NebraLtd/FlashStick/README.md

# FlashStick
Open source USB Adapters for popular compute modules
