NebraLtd/FlashStick/Raspberry Pi Compute Module 3/README.md

# Raspberry Pi Compute Module 1/3/3+ FlashStick

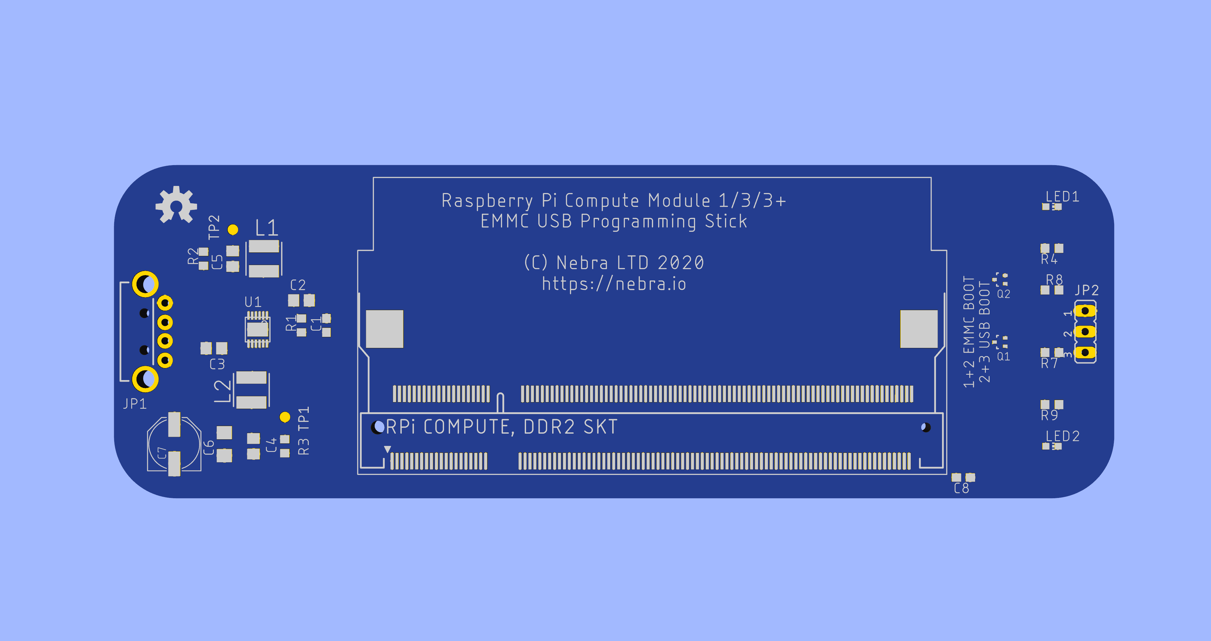
[picture p4: Raspberry Pi Compute Module 3/render-1.png]
Compute Module 1/3/3+ FlashStick


This FlashStick is designed for programming the Raspberry Pi Compute Module versions 1, 3 and 3+.

# How To Use

Operation should be as simple as:

1. Insert Compute Module 1, 3 or 3+ into FlashStick.
2. Ensure Jumper is in position 2+3.
3. Plug into Computer.
4. Load USB Boot Software (Or use Balena Etcher) to boot the CM into Programming Mode.
5. Flash image like normal.
6. Unplug stick from computer.
7. Remove compute Module.

*Care should be taken when handling the module and CM, handle from edge to reduce risk of ESD*

# PCB Specification

* **Thickness**: 1.6mm
* **Size**: 41x122mm
* **Colour**: Whatever you like, we went for blue!
* **Surface Finish**: You'll likely find assembly easier with ENIG due to the Power ICs package.
* **Stencil**: Recommended, top only. No Frame Needed.

This PCB can be quickly ordered directly from PCB companies using the following links:
* JLCPCB - CN Based - ~ $30 -
* PCBWay - CN Based - ~ $60 -
* OSHPark - US Based - ~ $70 -
* Aisler - EU Based - ~ $55 -

Or upload the Gerbers / BRD to your choice of Fab!

# Components

The BOM for shopping is in this folder.

Alternatively it's also available at [Octopart](https://octopart.com/bom-tool/03ZTTnCO) or on [Digi-key](https://www.digikey.com/short/zvwpn0)

# Assembly

We'll produce a little guide showing how we assemble them, and recommended pick and place order when doing it manually.

It's highly recommended for a Stencil to be used.

# Open Source Hardware Certification

This project is released under the [license shown here](https://github.com/NebraLtd/FlashStick/blob/main/LICENSE.md) and is also certified as [open source hardware](https://certification.oshwa.org/uk000023.html) by the [Open Source Hardware Association](https://www.oshwa.org/):

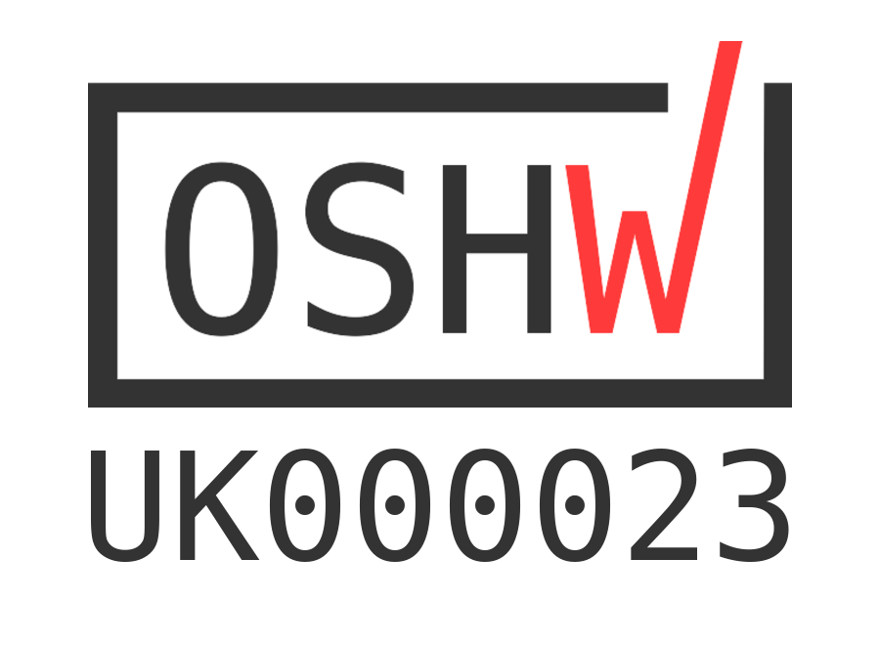
[picture p5: Raspberry Pi Compute Module 3/OSHW_mark_UK000023.png]
