NebraLtd/FlashStick/Raspberry Pi Compute Module 3/proto-1.jpg

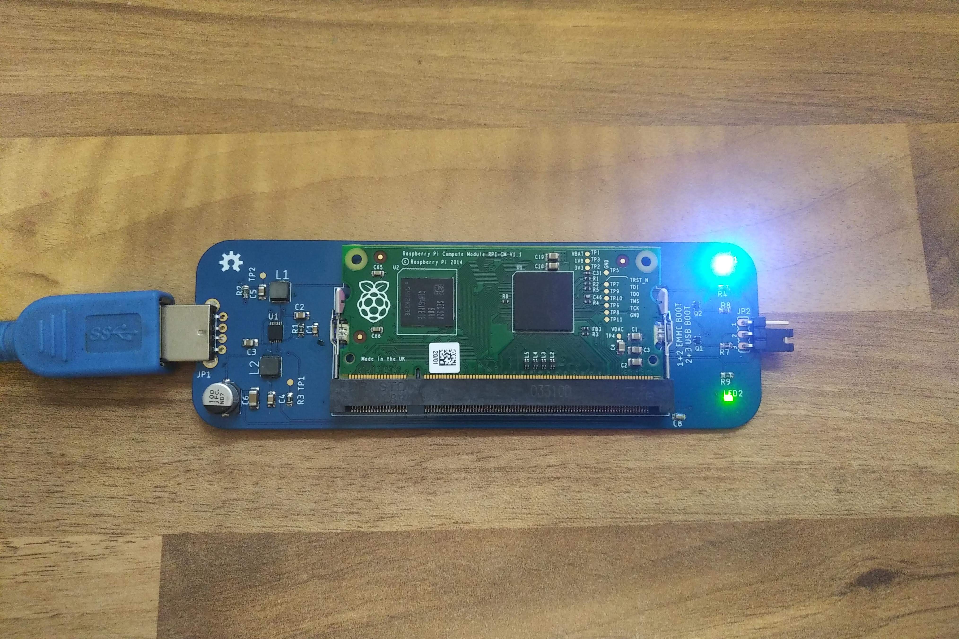
Raspberry Pi Compute Module 3/proto-1.jpg
