NebraLtd/FlashStick/Raspberry Pi Compute Module 3/proto-2.jpg

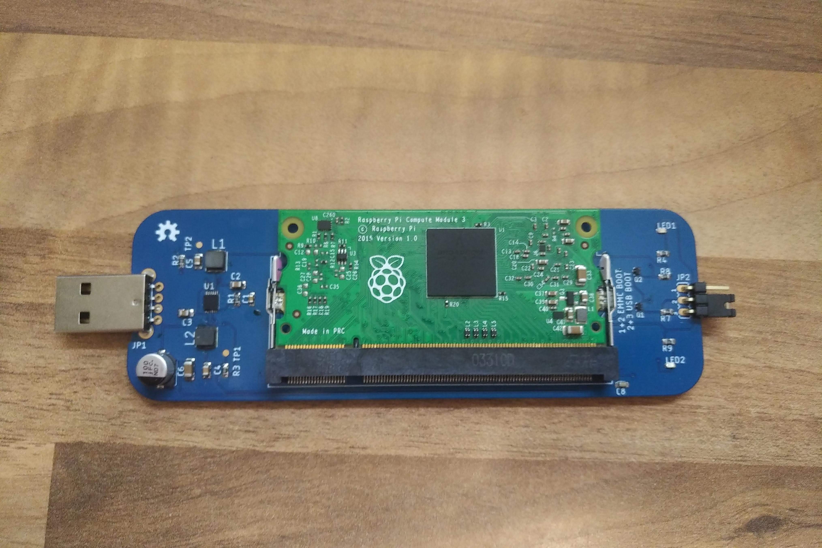
Raspberry Pi Compute Module 3/proto-2.jpg
