NebraLtd/FlashStick/Raspberry Pi Compute Module 3/proto-3.jpg

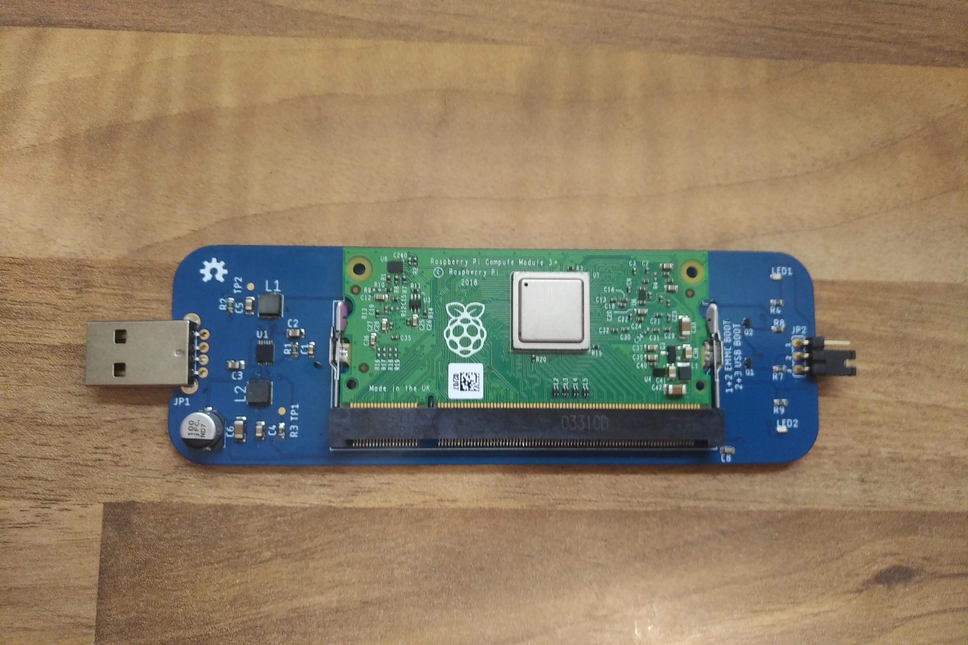
Raspberry Pi Compute Module 3/proto-3.jpg
