NebraLtd/FlashStick/Raspberry Pi Compute Module 3/render-2.png

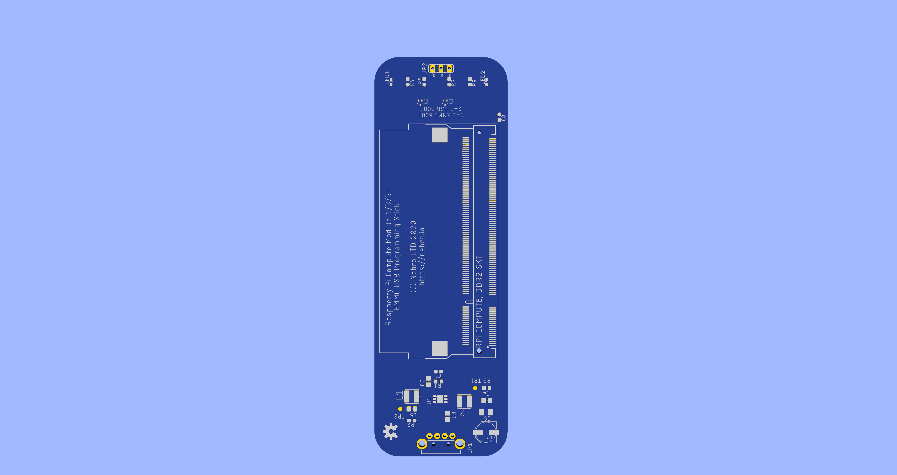
Raspberry Pi Compute Module 3/render-2.png
