NebraLtd/FlashStick/Raspberry Pi Compute Module 3/render-3.png

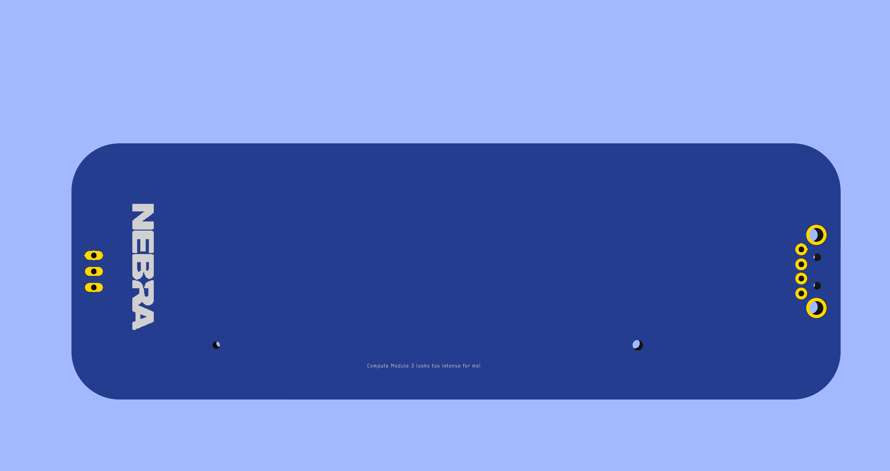
Raspberry Pi Compute Module 3/render-3.png
