NebraLtd/FlashStick/Raspberry_Pi_Compute_Module_4/Outputs/FlashStickCM4_top.jpg

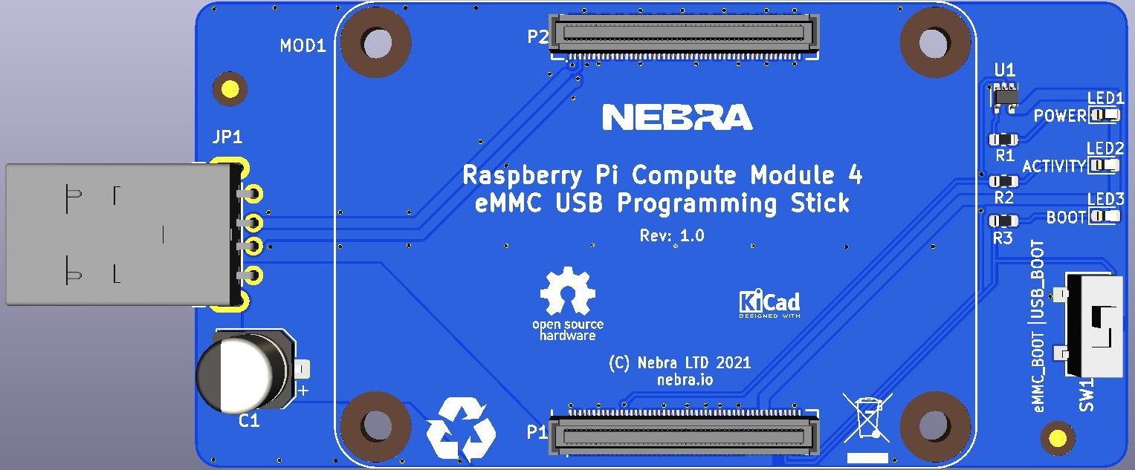
Raspberry_Pi_Compute_Module_4/Outputs/FlashStickCM4_top.jpg
