NebraLtd/FlashStick/(threads)

Thread 2 (2021-01-15):

Test / verify samples

shawaj, 2021-01-15:
Test samples and close this issue once design verified

shawaj, 2021-05-10:
All verified now but need to update main repo to reflect this

Closed 2021-08-01.

Thread 3 (2021-01-15):

CM4 Version

shawaj, 2021-01-15:
For when you have any bandwidth @ryanteck - not urgent of course :-)

shawaj, 2021-01-18:
@ryanteck actually just had an idea. Potentially could add on the back side of the CM3 PCB the connectors for the CM4

Then a single board can do both Cm1/3 and the cm4 as well.

Maybe uprate the USB to USB 3 for cm4 faster speeds or something

ryanteck, 2021-01-18:
I think for programming USB2 is used on the CM4 too (as USB3 is provided by a PCI-E chip which isn't present on the CM4).

ryanteck, 2021-01-18:
I think for the CM4 the circuitry is also a lot less, I think apart from providing power and the USB pins being connected it requires nothing else.

ryanteck, 2021-01-18:
Footprint https://github.com/shridattdudhat/Raspberry-Pi-Compute-Module-4-Eagle-Footprint

shawaj, 2021-01-18:
Was just a thought that you could kill 2 birds with one stone, for example in production environments where they program both cm3 and cm4 for things.

But yes I suppose there's merit in both - a combined one for certain environments and separate for others

ryanteck, 2021-01-18:
Shall I do a seperate one first then possibly do a combined one if the seperate one works?

My only other concern of a combined one would be if somebody tried to put both a CM3 and CM4 in at the same time.

I can't remember if I saw either but I think somewhere I saw that the lifetime of the CM4 connectors is less so it could be that it wears out quicker being cheaper over time to replace it with just the single. Not fully sure with that though.

ryanteck, 2021-01-18:
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

Rough idea

ryanteck, 2021-01-18:
I think actually the connector would be the main reason to have it seperate as if it wears down this quickly the boards might not last long.

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

shawaj, 2021-01-18:
@ryanteck that's awful haha. It's like they didn't think about production environments at all. But yeah maybe start with a cm4 standalone and then do a combined one after potentially

shawaj, 2021-01-18:
I wonder if you can get solderless USB edge connectors too.

Could be cool to have an option for the USB connector to be on the top left, bottom left as well

Like this...

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

ryanteck, 2021-01-18:
One where the PCB is the connector?

shawaj, 2021-01-18:
Well - potentially - but what I was actually thinking was more like an edge connector that you could clamp a USB jack onto.

So effectively you could have 3 different locations for the USB jack that you could change between.

Similar to this, but instead of for a cable, for a PCB - https://www.aliexpress.com/i/32859840759.html

Not sure it actually exists though!!

shawaj, 2021-05-10:
CM4 version https://github.com/NebraLtd/FlashStick/tree/main/Raspberry_Pi_Compute_Module_4

Still needs testing though so will leave this open for now

shawaj, 2021-08-01:
Working now

Closed 2021-08-01.

Thread 4 (2021-01-15):

Support other compute modules / boards?

shawaj, 2021-01-15:
Starting this issue to look into adding other board support.

Etcher is working on supporting BealgeBone and some other devices in future. And obviously Fin and other CM Lite boards are compatible too already.

Thread 6 (2021-01-20):

FlashStick Duo

shawaj, 2021-01-20:
Just had another potential idea.

Could add a 2 port USB hub and another CM3 holder on the back.

Then potentially could have 2 x CMs on a single FlashStick.

Similar footprint but double the programming qty.

ryanteck, 2021-01-20:
Could possibly do this.

I"ll first try when I get a couple of prototypes through both on a USB2 hub to see if the speed is affected.
It could be slower than one then the throughput isn't any higher.

The only other thing I need to check is clearance.

shawaj, 2021-01-20:
I think the throughput is fairly limited by the USB 2 anyway yes

ryanteck, 2021-01-20:
I was thinking a USB 2 hub on the stick itself. But wasn't sure if that would bottleneck the units or if the bottleneck is the Pi itself.

Will test it when I can

ryanteck, 2021-01-20:
Other potential solution could be two side by side rather than back to back as on the USB3 hub we got there's not enough clearance for back to back unfortunately.

Or possibly because there's the hub, could go two on each side. But would definitely want to test if that would bottleneck the usb hub on board.

ryanteck, 2021-01-20:
Done some rough tests.

Looks like there might *just* be enough clearance on the 16 port USB 3 hubs we got to try.

I did wonder about 4, however I think for bottleneck reasons 2 should be fine per board.

Rough tests showed with a USB3 drive plugged into a USB2 port on my computer balena writes at around 21MB/s, where as compute modules are around 7-9MB/S so two should be fine.

Thread 8 (2021-07-30):

Hardware issue on CM4 rev 1.0 samples

shawaj, 2021-07-30:
As discussed with @mmilann over email, there is an issue on the rev 1.0 hardware.

Suspected issue is GPIO_VREF needing to be pulled to 3V3.

shawaj, 2021-08-01:
Fixed by c0217e44a00e342ccd957bfe142bfbc6fd33cbb3

Also can be fixed by following:
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

Closed 2021-08-01.
