NebraLtd/FlashStick/Raspberry_Pi_Compute_Module_4/Outputs/FlashStickCM4_schematic.pdf

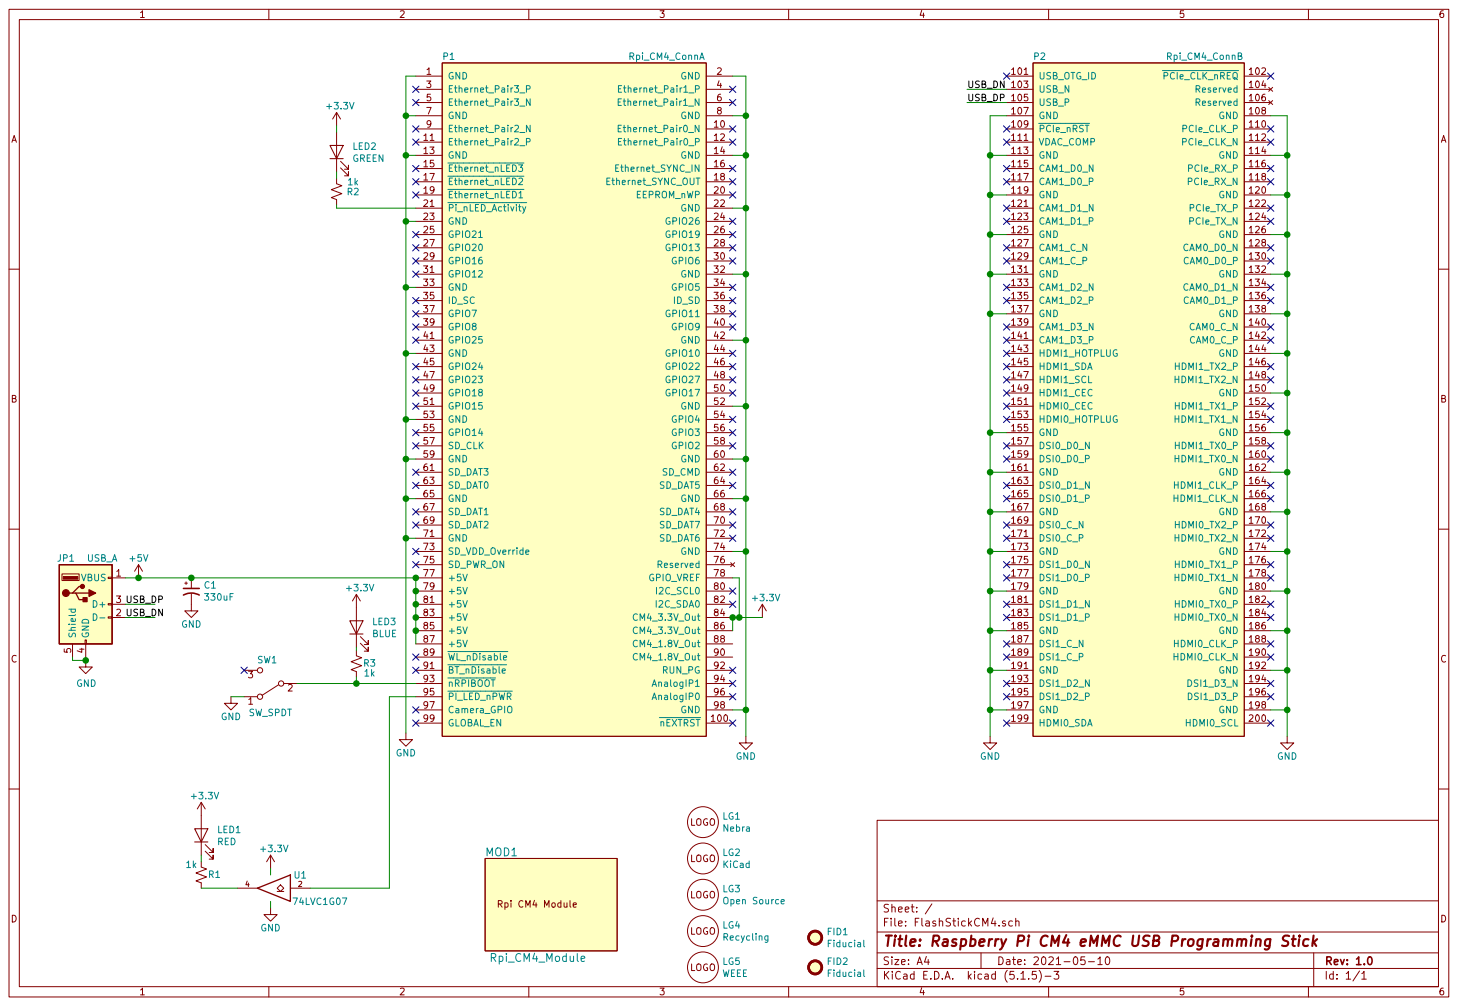
[picture p12: page 1]

File: FlashStickCM4.sch Sheet: / LED3 BLUE

MOD1
LOGO LG2 KiCad Rpi CM4 Module

Id: 1/1 Title: Raspberry Pi CM4 eMMC USB Programming Stick
