NebraLtd/FlashStick/Raspberry_Pi_Compute_Module_4/Outputs/FlashStickCM4_layers.pdf

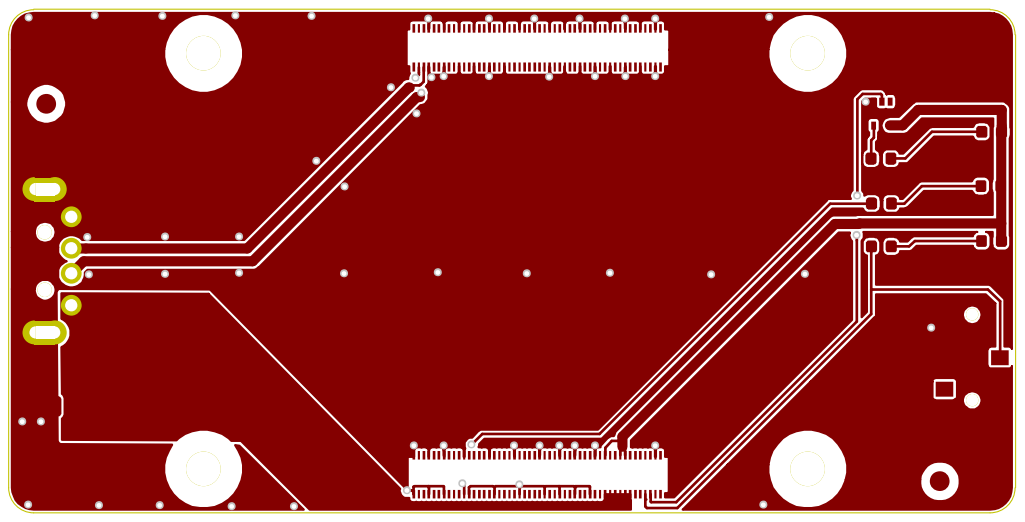
[picture p13: page 1]

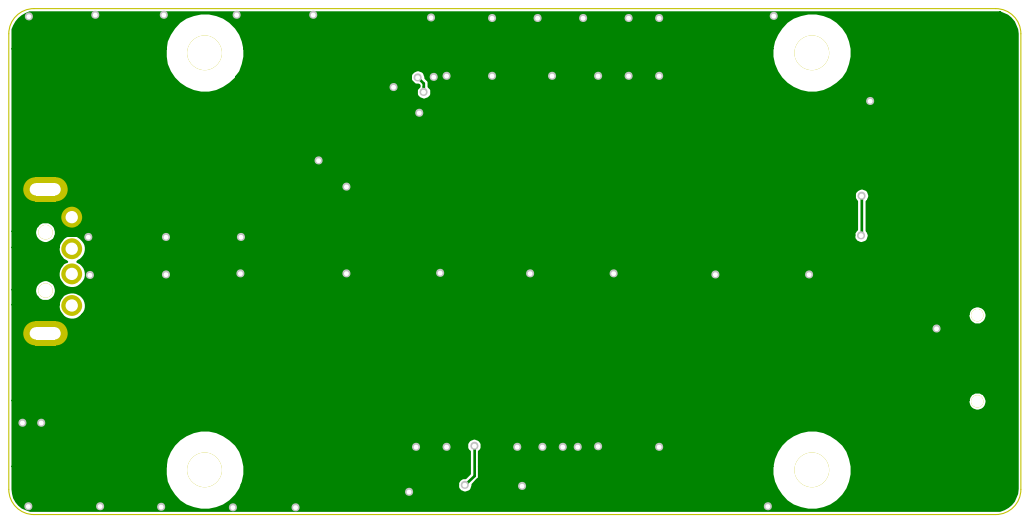
[picture p14: page 2]

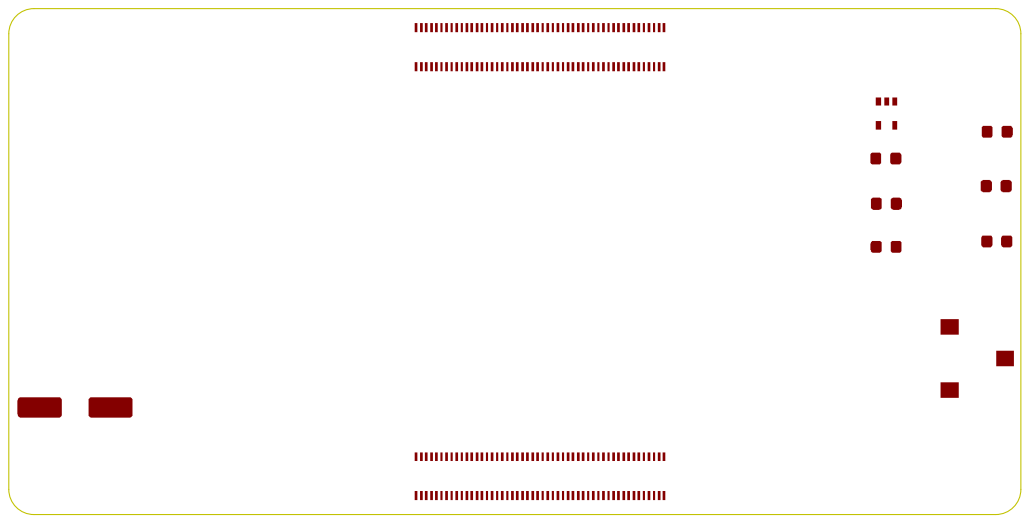
[picture p15: page 4]

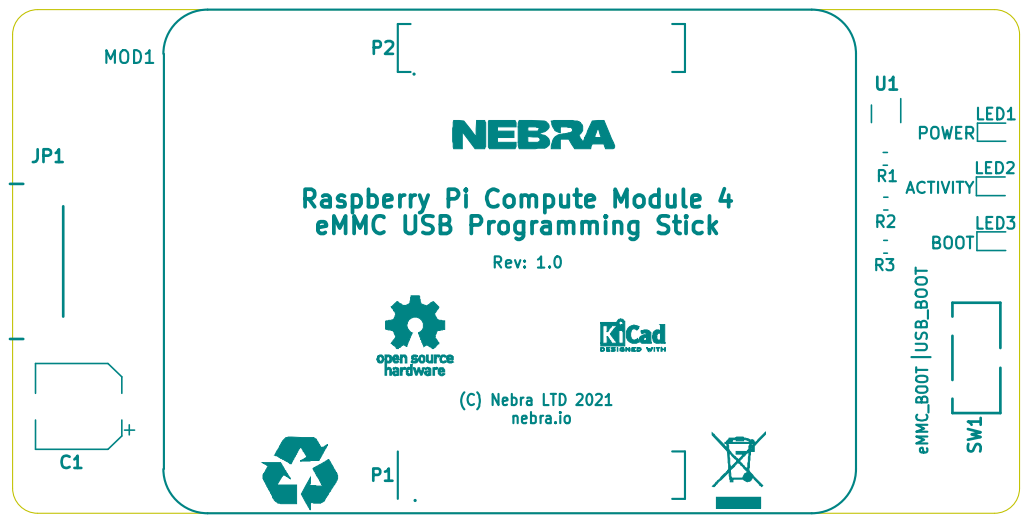
[picture p16: page 5]

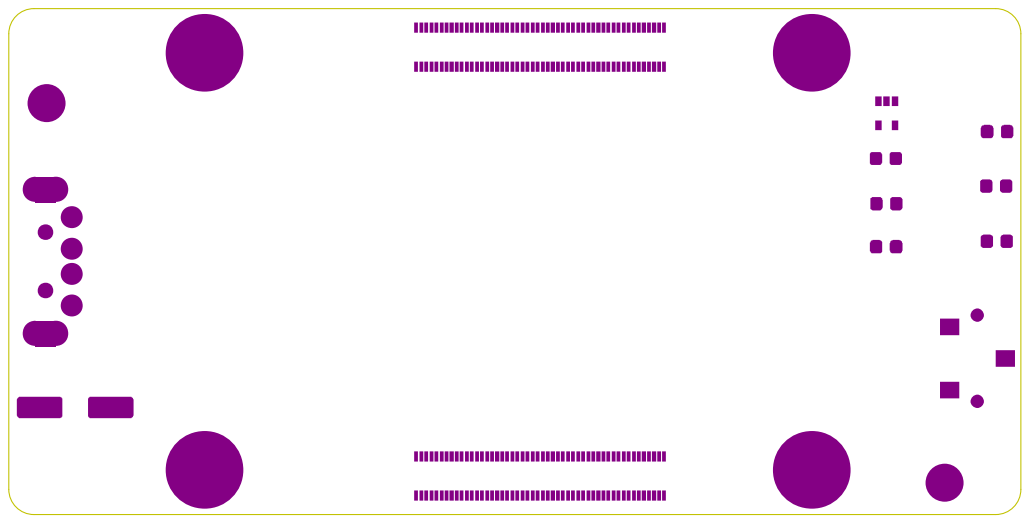
[picture p17: page 7]

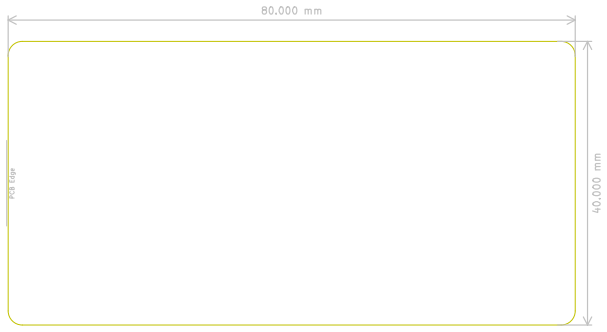
[picture p18: figure]

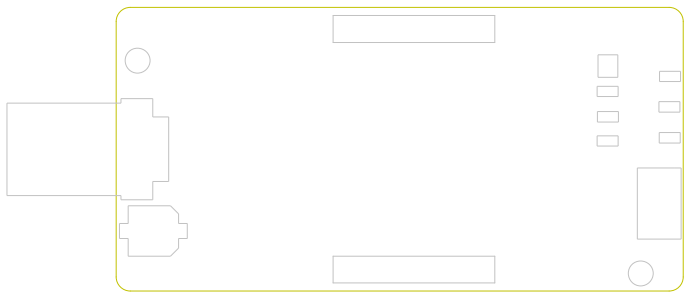
[picture p19: figure]

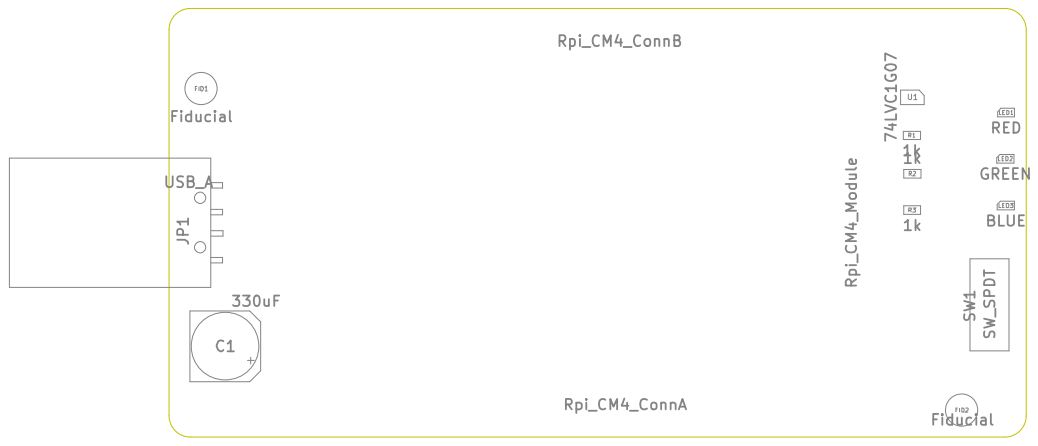
[picture p20: page 12]
