NebraLtd/FlashStick/(commit log)

2020-12-06 Add first gerbers, approval needed.
    [BOM_cm3-adaptor-board.csv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]
2020-12-06 Tweak BOM
    [BOM_cm3-adaptor-board.csv]
2020-12-06 Change resistors to not be as bright.
    [BOM_cm3-adaptor-board.csv]
2020-12-06 Add PCB info
2020-12-06 BOM Work
    [BOM-CM3-FlashStick.csv, BOM-CM3-FlashStick.ods, cm3-adaptor-board.brd, cm3-adaptor-board.sch]
2020-12-28 New gerbers
    [BOM_cm3-adaptor-board.csv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]
2020-12-29 New board file
    [cm3-adaptor-board.brd]
2020-12-29 Add new gerbers
2021-05-10 FlashStickCM4 Initial Design Rev 1.0
    [FlashStickCM4.csv, FlashStickCM4.kicad_pcb, FlashStickCM4.sch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]
2021-07-31 Fixed missing GPIO_VREF to 3V3 connection.
    [FlashStickCM4.kicad_pcb, FlashStickCM4.sch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]
